Aquaphor-123/ResetDendy/other/img/Dendy1.jpg

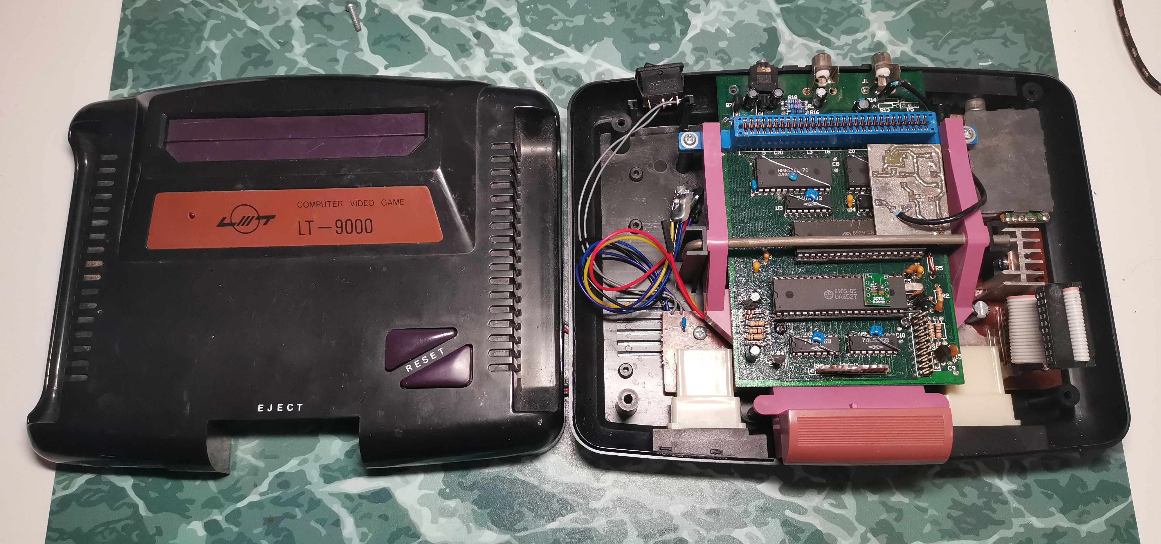
other/img/Dendy1.jpg
