Aquaphor-123/ResetDendy/other/img/Dendy4.jpg

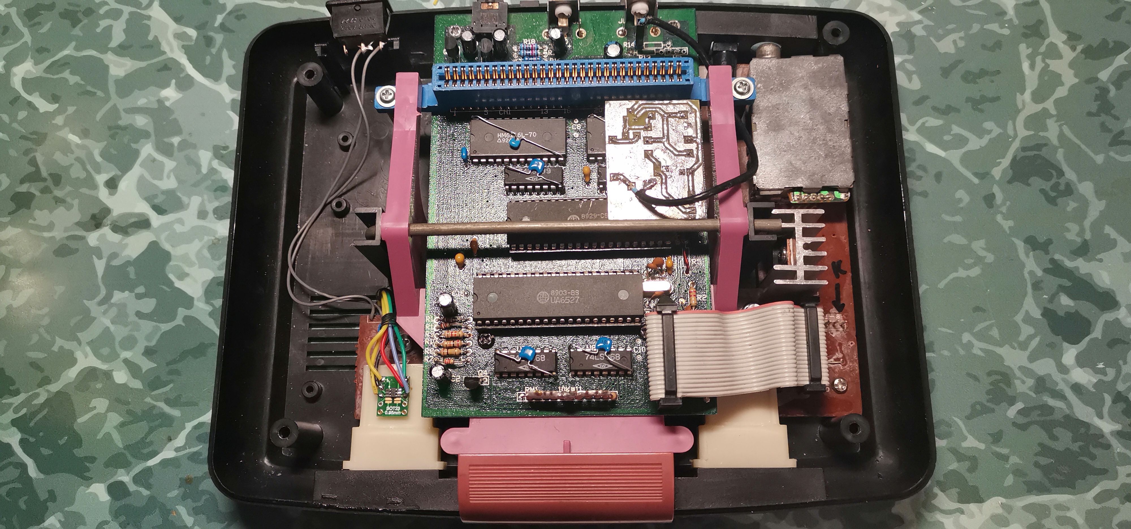
other/img/Dendy4.jpg
