Aquaphor-123/ResetDendy/other/circuit/3e804dc10ee79305bf9a49dc66c2ded2.jpeg

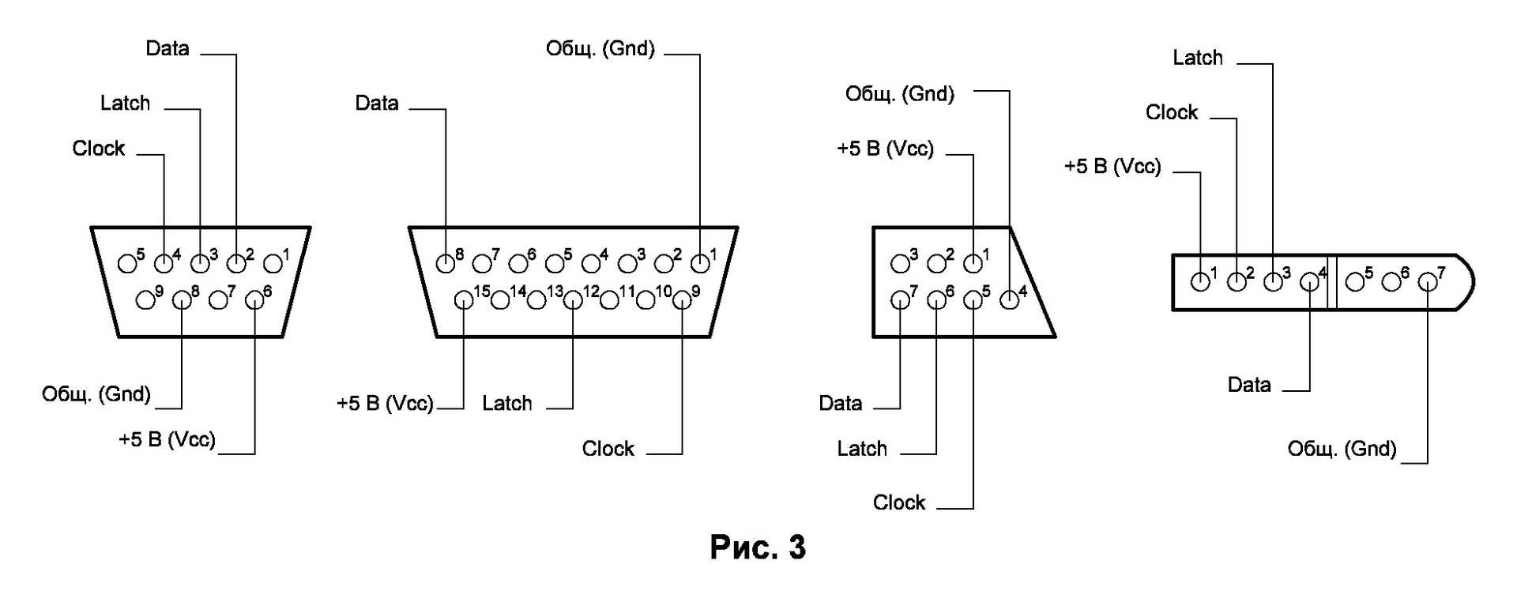
other/circuit/3e804dc10ee79305bf9a49dc66c2ded2.jpeg
