Aquaphor-123/ResetDendy/other/circuit/Dendy1.png

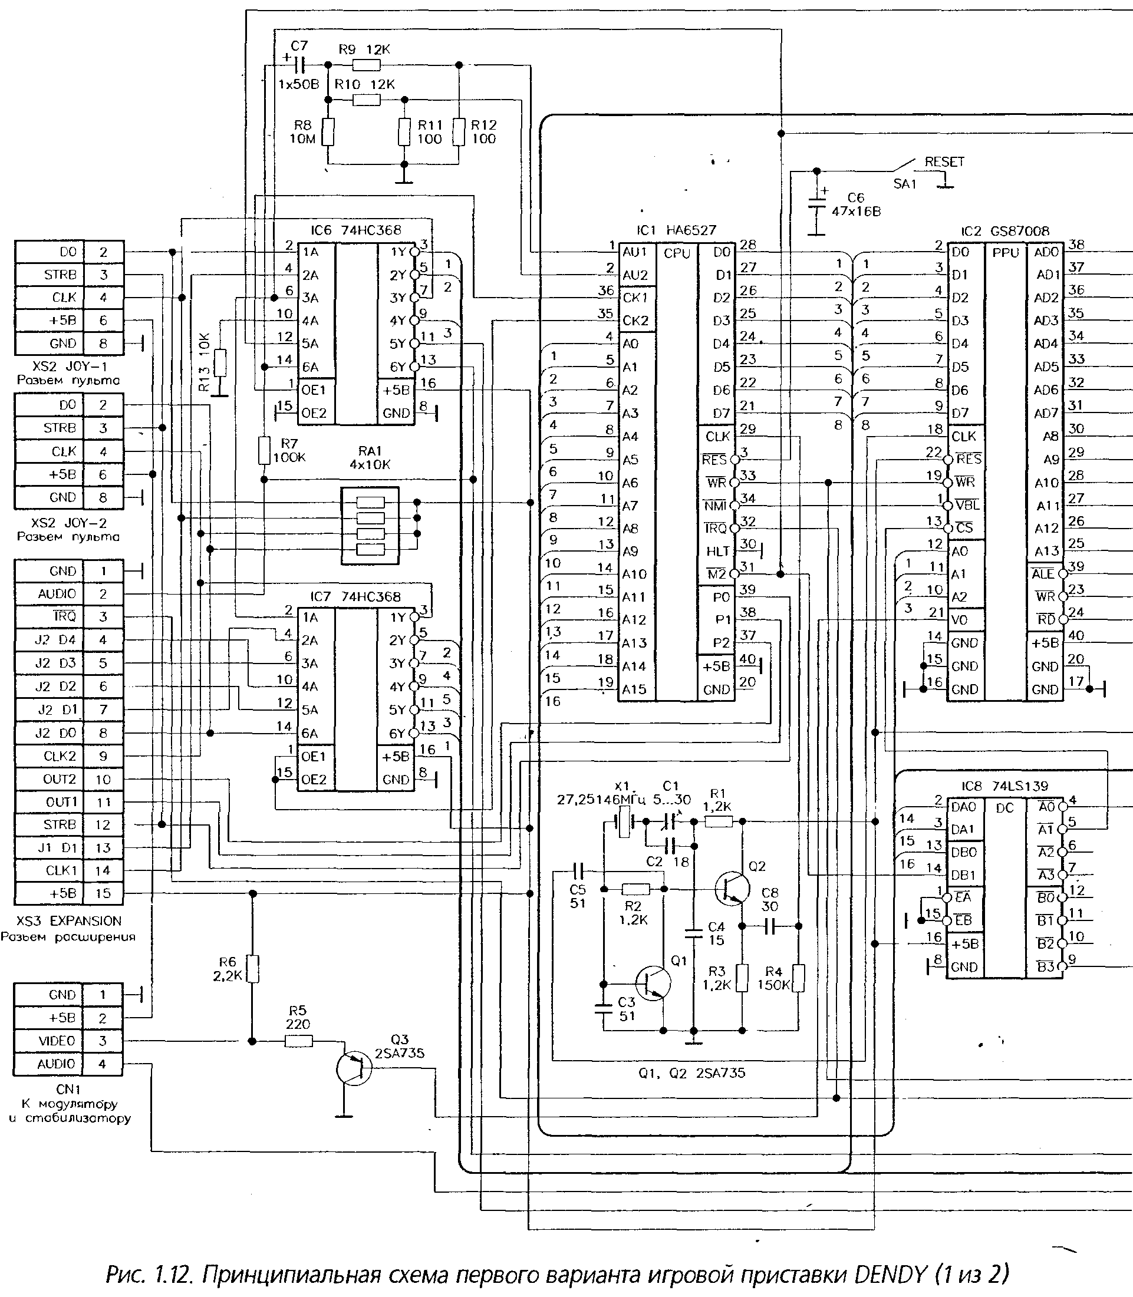
other/circuit/Dendy1.png
