Aquaphor-123/ResetDendy/other/circuit/Dendy2.png

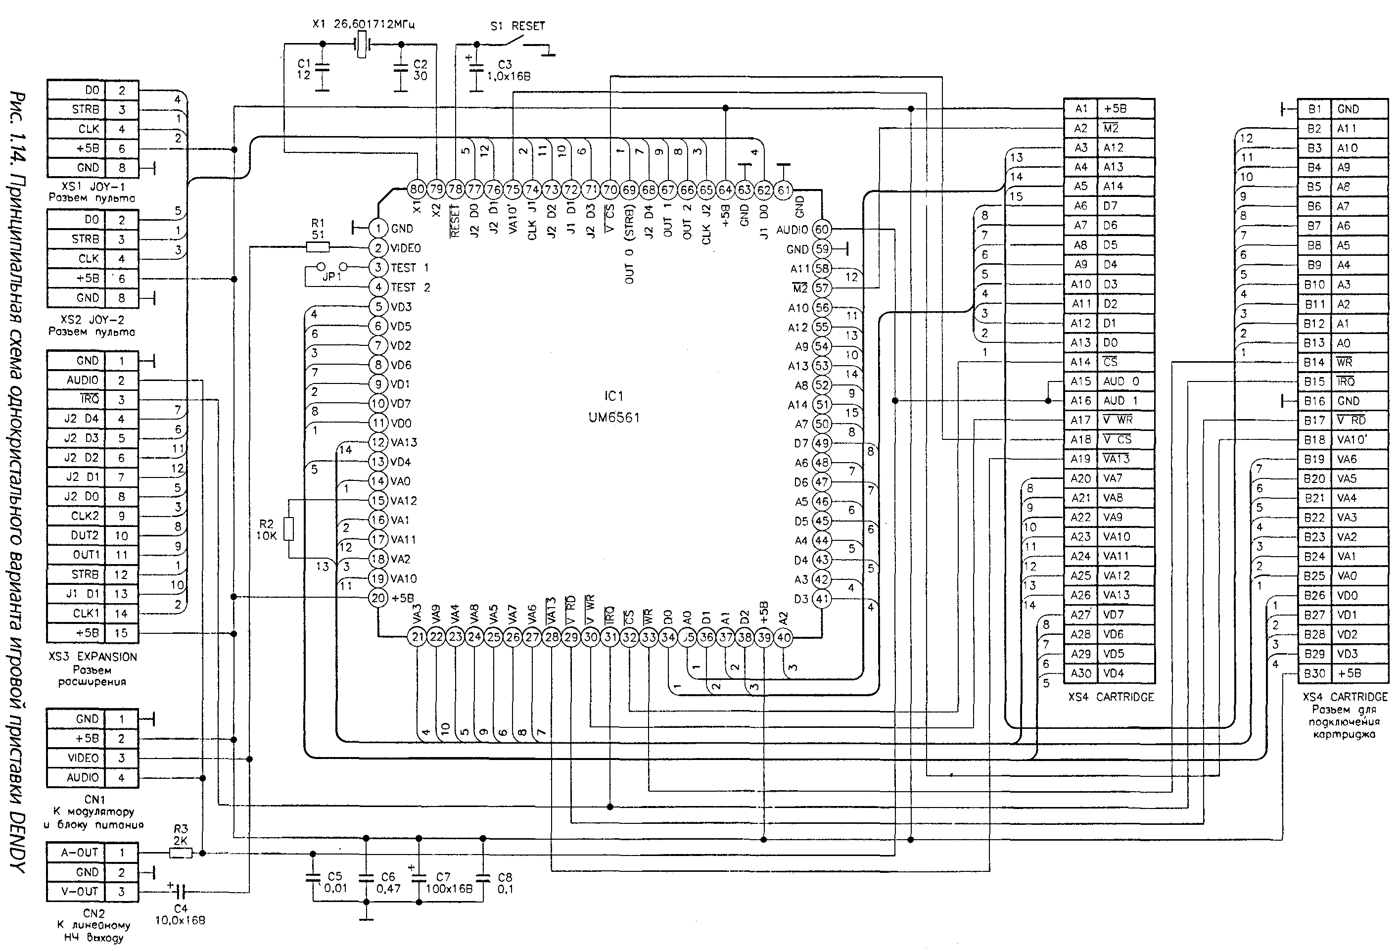
other/circuit/Dendy2.png
