Aquaphor-123/ResetDendy/other/circuit/Джойстик.png

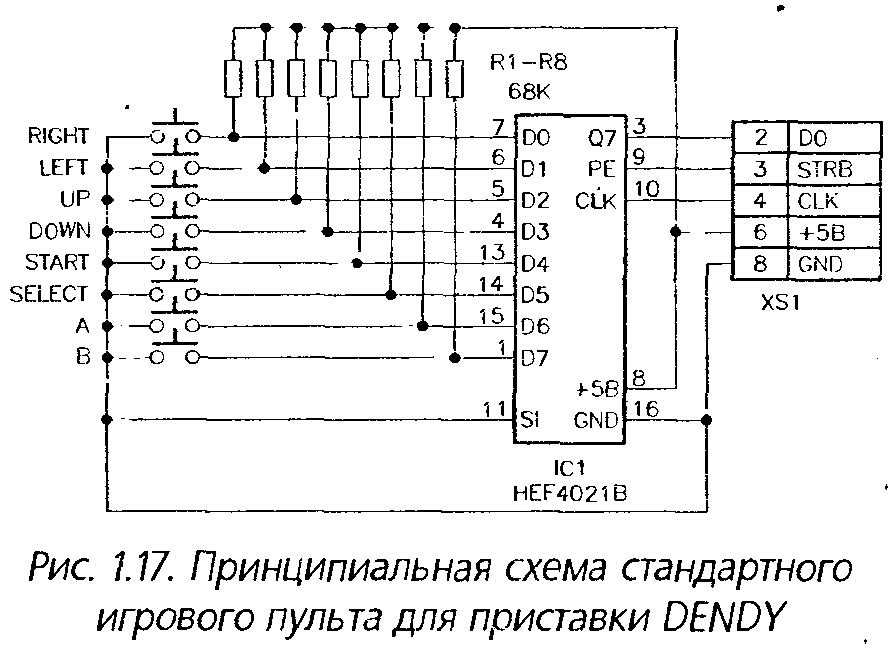
other/circuit/Джойстик.png
