Aquaphor-123/ResetDendy/other/img/Dendy2.jpg

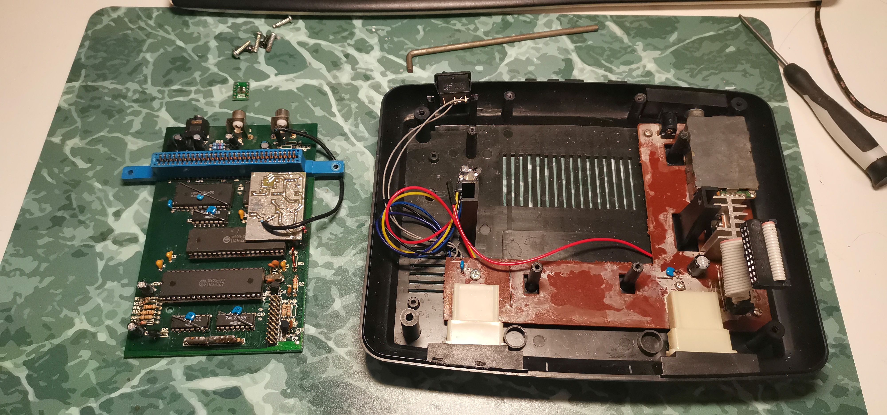
other/img/Dendy2.jpg
