Aquaphor-123/ResetDendy/other/img/Dendy3.jpg

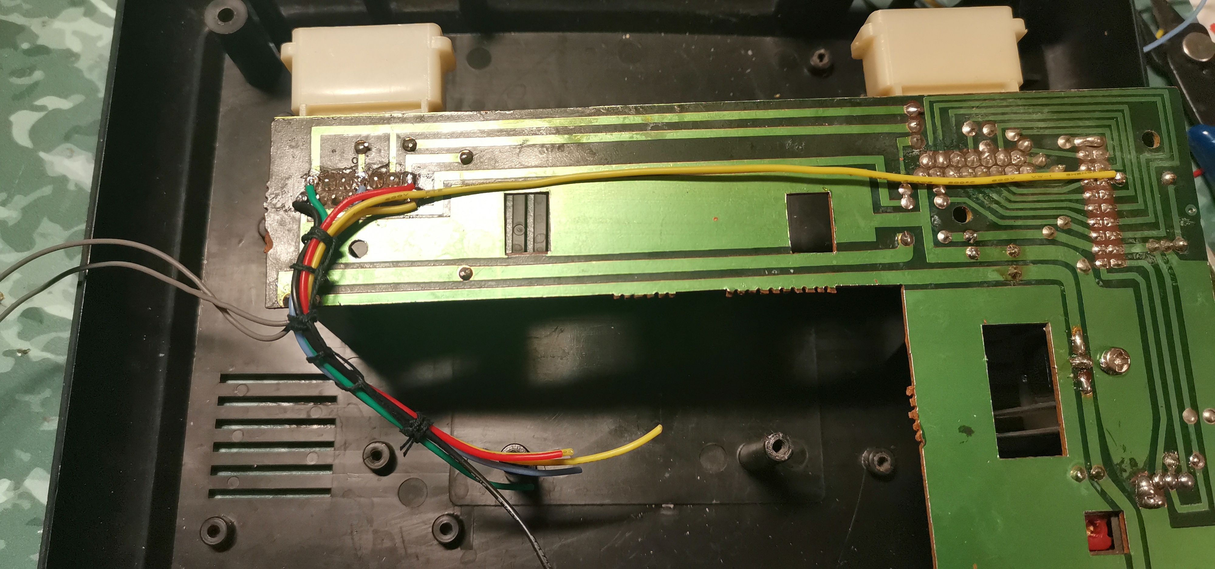
other/img/Dendy3.jpg
