Aquaphor-123/ResetDendy/pcb/PCB_BOTTON.jpg

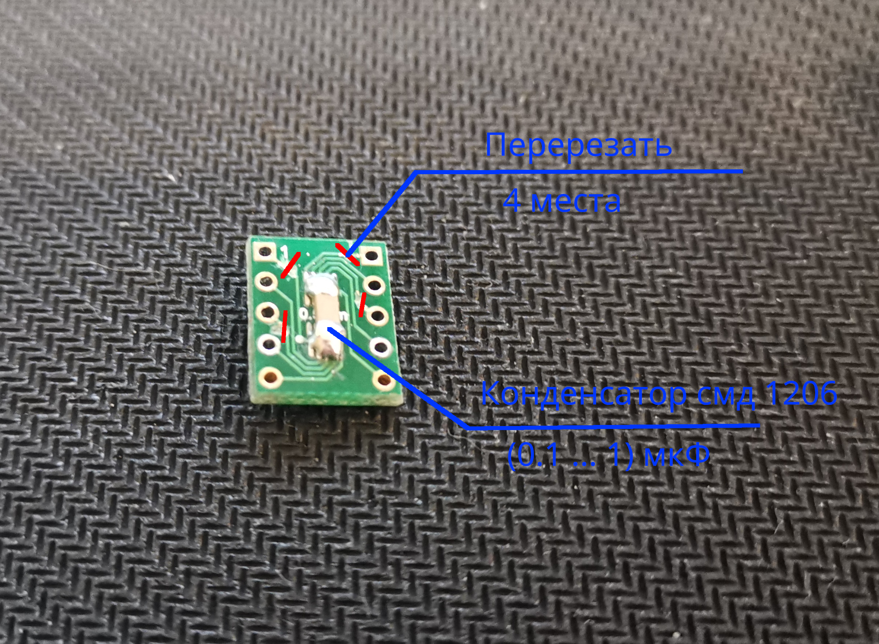
pcb/PCB_BOTTON.jpg
