Aquaphor-123/ResetDendy/pcb/PCB_TOP.jpg

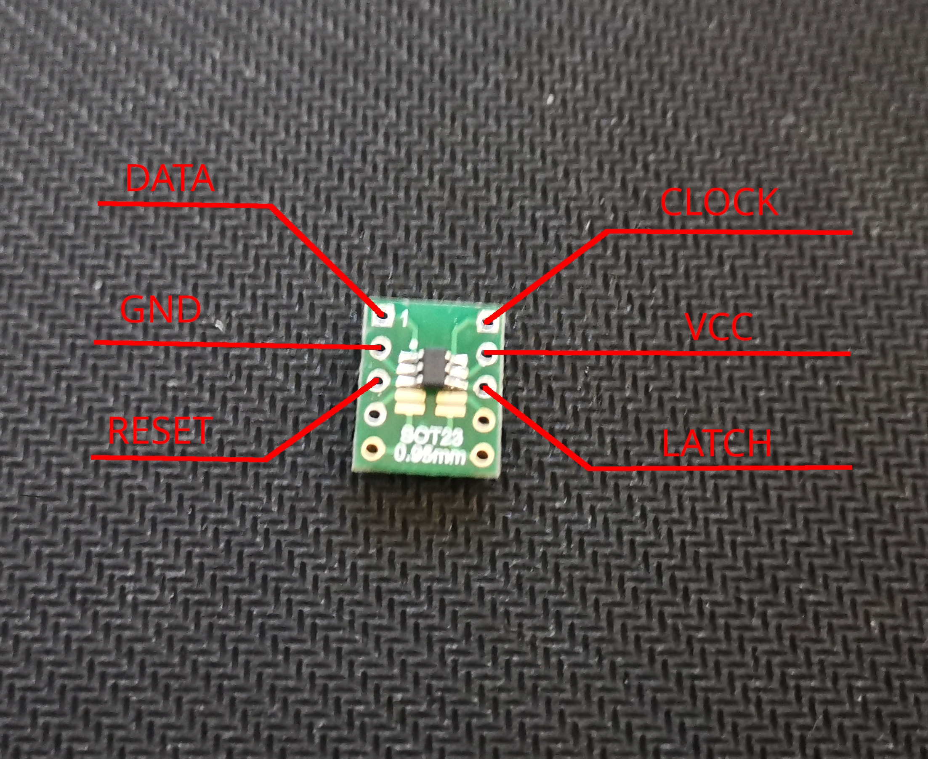
pcb/PCB_TOP.jpg
