Aquaphor-123/ResetDendy/pcb/Переходная плата sot23.jpg

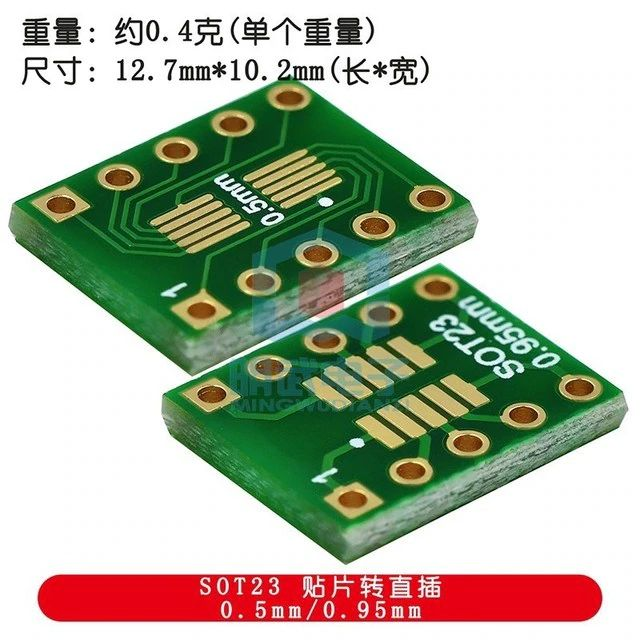
pcb/Переходная плата sot23.jpg
