Aquaphor-123/ResetDendy/(commit log)

2023-07-21 Первый раз тут
2023-07-21 JPG
    Изменение формата файла
2023-09-23 Increasing the frequency of the system generator.
    Due to the too short duration of the "CLOCK" pulse (300 ns), sometimes the "CLOCK" pulse is skipped. The frequency is increased so that the machine cycle is approximately 100 ns.
    [main.asm]
2024-02-10 Transcation of launch + exchange emulator
    Tracking the launch by the presence of a CLOCK. Added the code of the joystick exchange simulator on the Arduino nano, for debugging.
2024-02-11 Interrupt fixes
    The interrupt does not have time to catch the "CLOCK". Changed to "LATCH".
    [main.asm]
2026-05-15 Добавлена возможность выбора режима работы с геймпадом 8BitDo N30
    1) Вынес настройки в отдельный файл.
    2) Добавил комбинацию для сброса по нажатию кнопки Home джойстика 8BitDo N30.
    3) Орфография))).
2026-05-15 Правка справки. Перевод настроек.
2026-05-30 Правка текста и перевода.
